mzurmand/Z35_Hardware/R&D/Research/TP4056 - OSHWLab_files/photo(1).jpg

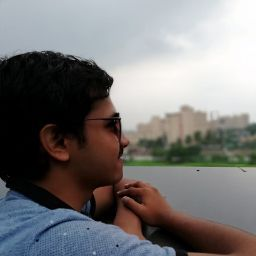
R&D/Research/TP4056 - OSHWLab_files/photo(1).jpg
