mzurmand/Z35_Hardware/R&D/Research/TP4056 - OSHWLab_files/photo.jpg

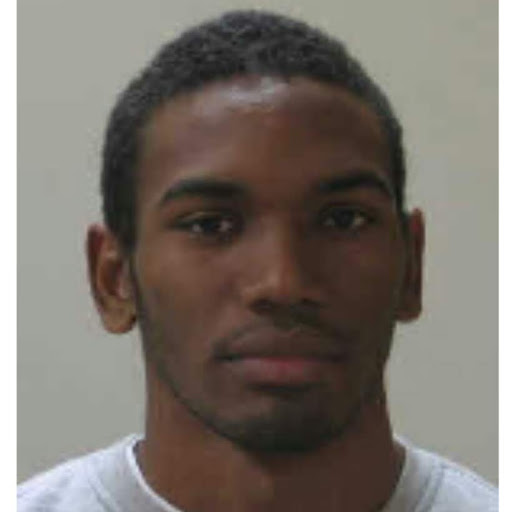
R&D/Research/TP4056 - OSHWLab_files/photo.jpg
