mzurmand/Z35_Hardware/R&D/Research/1c86db0516be416c5981fb073d690a169595acf9_2_500x334.jpeg

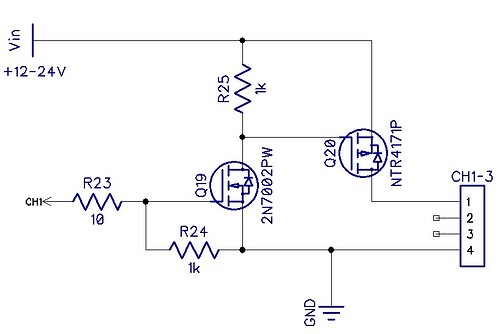
R&D/Research/1c86db0516be416c5981fb073d690a169595acf9_2_500x334.jpeg
