mzurmand/Z35_Hardware/R&D/Research/ebb98466-46d4-4202-9cf7-b3be1f33b6aa.jpg

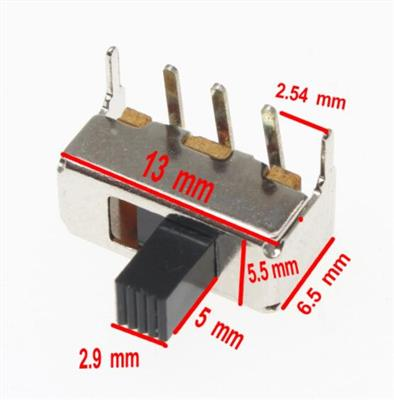
R&D/Research/ebb98466-46d4-4202-9cf7-b3be1f33b6aa.jpg
