mzurmand/Z35_Hardware/R&D/Research/N mosfet driving P mosfet - Other Hardware _ Motors, Mechanics, Power and CNC - Arduino Forum_files/a19560f0b2fe2e72ee76713fce2fe01bb80f32ff_2_690x467.jpeg

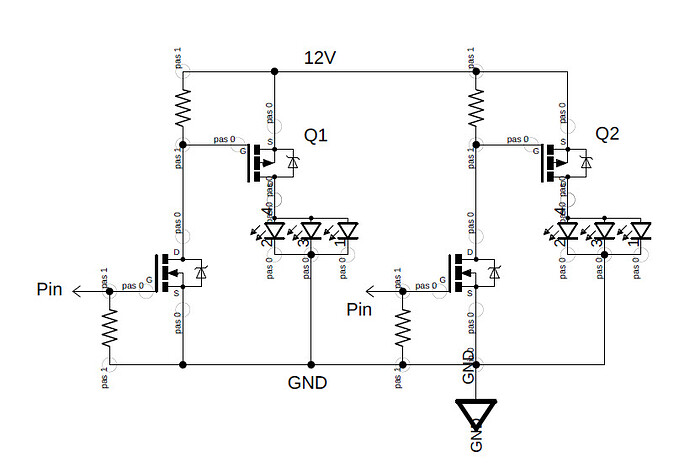
R&D/Research/N mosfet driving P mosfet - Other Hardware _ Motors, Mechanics, Power and CNC - Arduino Forum_files/a19560f0b2fe2e72ee76713fce2fe01bb80f32ff_2_690x467.jpeg
