mzurmand/Z35_Hardware/R&D/Research/TP4056 - OSHWLab_files/IDo7Sh7YOtRhSln7knlJHtKrr99G3mUUojS3hKja.jpeg

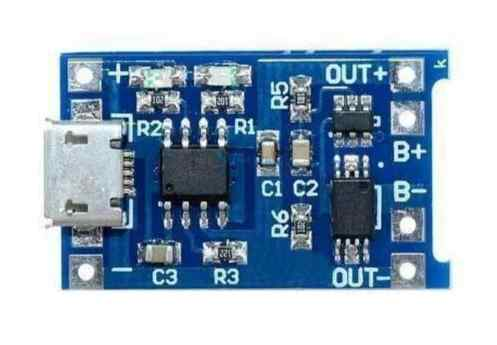
R&D/Research/TP4056 - OSHWLab_files/IDo7Sh7YOtRhSln7knlJHtKrr99G3mUUojS3hKja.jpeg
