mzurmand/Z35_Hardware/R&D/Research/TP4056 - OSHWLab_files/RLOdjxhjYpKyfk1iUPSjZLQWYawQvPg69q5MmfHB.png

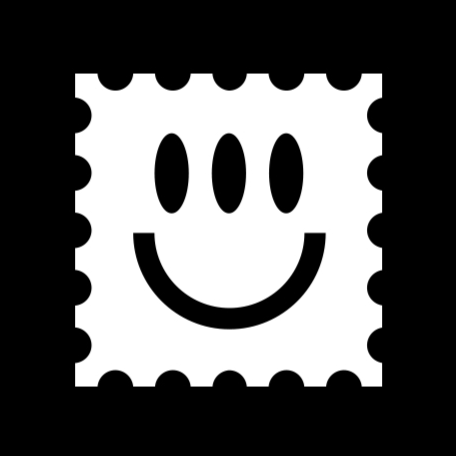
R&D/Research/TP4056 - OSHWLab_files/RLOdjxhjYpKyfk1iUPSjZLQWYawQvPg69q5MmfHB.png
