mzurmand/Z35_Hardware/R&D/Research/TP4056 - OSHWLab_files/uWVNVODcDzgOFQ3FyNXB1rH79NLc275yuhar6eYj.jpeg

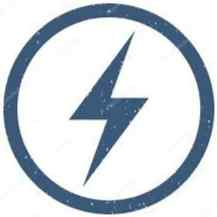
R&D/Research/TP4056 - OSHWLab_files/uWVNVODcDzgOFQ3FyNXB1rH79NLc275yuhar6eYj.jpeg
