mzurmand/Z35_Hardware/R&D/TP4056 - OSHWLab_files/no-content.81aa631d.png

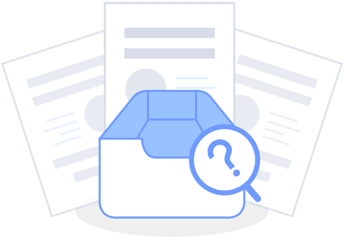
R&D/TP4056 - OSHWLab_files/no-content.81aa631d.png
