mzurmand/Z35_Hardware/R&D/TP4056 - OSHWLab_files/O2vb7wtJYsDGfwBd00tpWdqS6tXn5qfObE9fvtKy.png

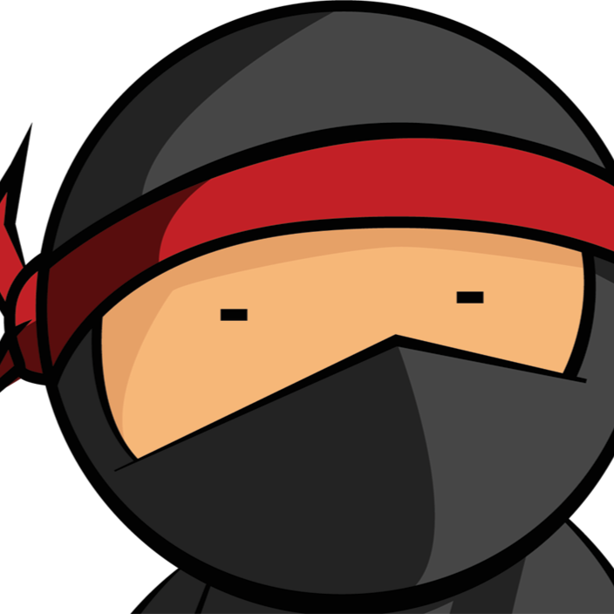
R&D/TP4056 - OSHWLab_files/O2vb7wtJYsDGfwBd00tpWdqS6tXn5qfObE9fvtKy.png
