mzurmand/Z35_Hardware/R&D/TP4056 - OSHWLab_files/PfCtYKN4fJ545DFiAe96VsUarYVP0kseUWtu5ZxB.jpeg

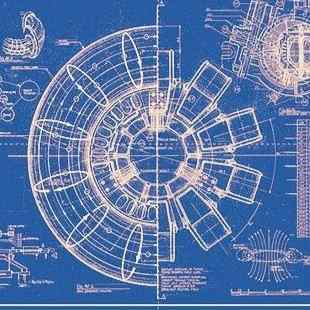
R&D/TP4056 - OSHWLab_files/PfCtYKN4fJ545DFiAe96VsUarYVP0kseUWtu5ZxB.jpeg
