mzurmand/Z35_Hardware/R&D/Wireless box/1-22.jpg.webp

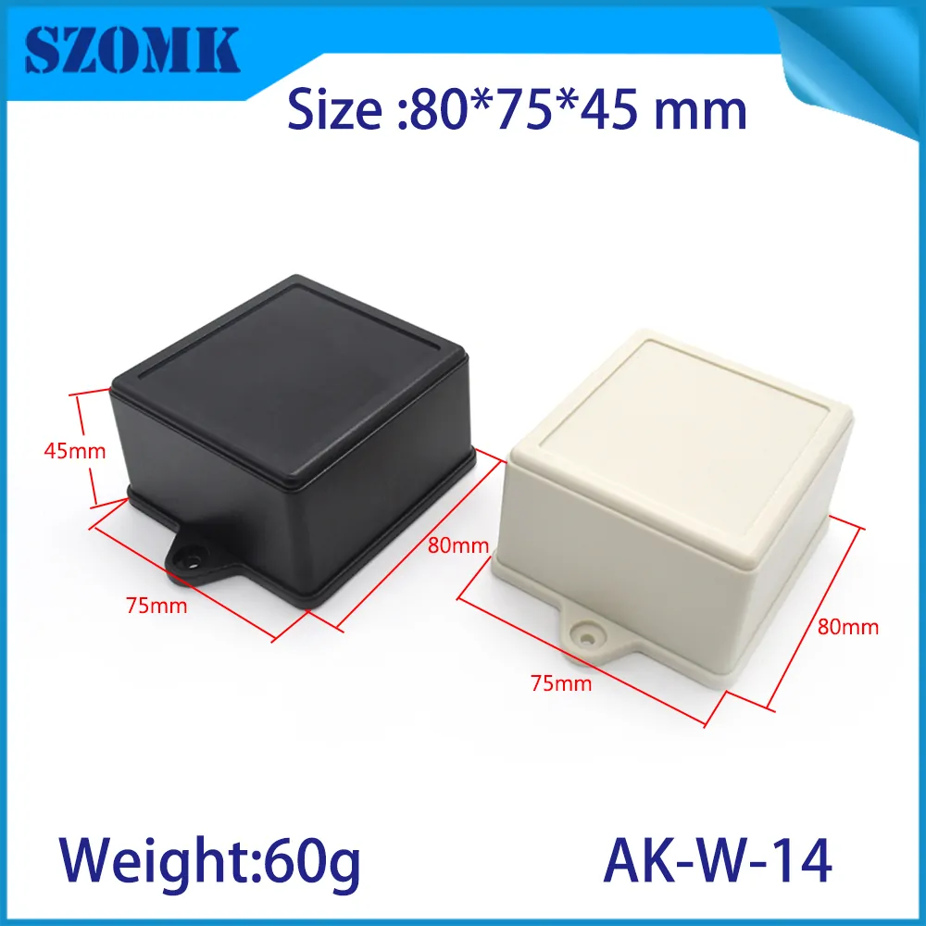
R&D/Wireless box/1-22.jpg.webp
