mzurmand/Z35_Hardware/R&D/Wireless box/4-23.jpg.webp

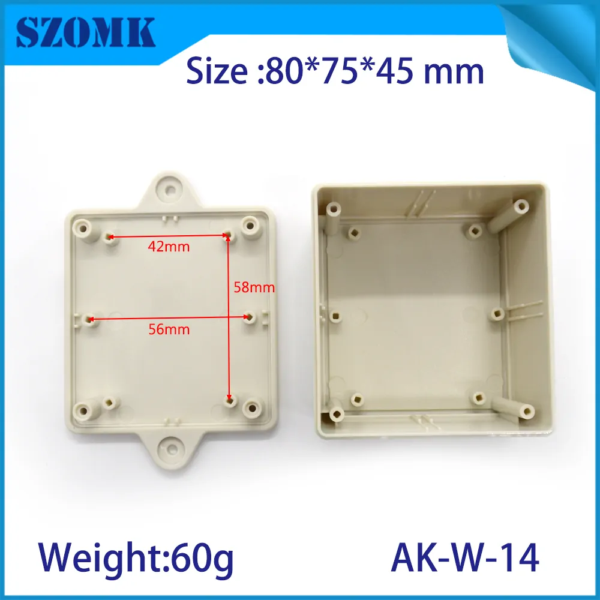
R&D/Wireless box/4-23.jpg.webp
