mzurmand/Z35_Hardware/Z35.xlsx

Line # | Name | Description | Designator | Quantity | Manufacturer 1 | Manufacturer Part Number 1 | Manufacturer Lifecycle 1 | Supplier 1 | Supplier Part Number 1 | Supplier Unit Price 1 | Supplier Subtotal 1
 | USB Connector | USB Connector-A Type | ADC1, ADC2, GSM1, SHT1 | 4
 | LCD | Alphanumic LCD | ALCD1 | 1
 | CR2032 | Battry Backup | BT1 | 1
 | 1000uF | Cap electrolitic radial | C1, C6, C61, C76 | 4
 | 10uF | Cap electrolitic radial | C2, C3, C8, C11, C62, C73, C78 | 7
 | 100uF | Cap electrolitic radial | C4 | 1
 | 220uF | Cap electrolitic radial | C5 | 1
 | 100nF/400v | Bipolar Capacitor | C7 | 1
 | 2.2uF-50v | Cap electrolitic radial | C9 | 1
 | 1000u | Cap electrolitic radial | C10 | 1
 | 10uF-50v | Cap electrolitic radial | C12 | 1
 | 100nF | CAP 0805 | C13, C22, C25, C27, C32, C33, C35, C36, C37, C40, C43, C44, C45, C46, C47, C48, C49, C60, C71, C74, C75, C77, C80 | 23
 | 100nF | 0603 C 100nF Ceramic Multilayer Capacitor, 25 V, +125degC, X7R Dielectric, +/-5% | KEMET C0603C104J3RACTU | C14, C15, C17, C23, C26, C30, C31, C38, C39, C51, C52, C55, C56, C57, C58, C59 | 16
 | 1uF | 0603 C 100nF Ceramic Multilayer Capacitor, 25 V, +125degC, X7R Dielectric, +/-5% | KEMET C0603C104J3RACTU | C16, C19 | 2
 | 15pF | 0603 C 100nF Ceramic Multilayer Capacitor, 25 V, +125degC, X7R Dielectric, +/-5% | KEMET C0603C104J3RACTU | C18, C24, C28, C29, C53, C54 | 6
 | 10nF | 0603 C 100nF Ceramic Multilayer Capacitor, 25 V, +125degC, X7R Dielectric, +/-5% | KEMET C0603C104J3RACTU | C20 | 1
 | 4.7uF | 0603 C 100nF Ceramic Multilayer Capacitor, 25 V, +125degC, X7R Dielectric, +/-5% | KEMET C0603C104J3RACTU | C21, C50 | 2
 | 15pF | CAP 0805 | C34, C42 | 2
 | 470nF | CAP 0805 | C41 | 1
 | 10uF | CAP 0805 | C63, C64, C70, C72 | 4
 | 10uF | 0603 C 100nF Ceramic Multilayer Capacitor, 25 V, +125degC, X7R Dielectric, +/-5% | KEMET C0603C104J3RACTU | C65, C66 | 2
 | 22uF | CAP 0805 | C67, C68, C69 | 3
 | BTA41 |  | CR1 | 1
 | LED 5MM | Light Emitting Diode | D1, D2, D3, D4, D5, D6, D7, D8 | 8
 | SMD 1N4007 | Diode SMD Pakage | D9, D10, D14, D15, D16, D17, D18, D19, D20, D24, D25 | 11
 | SS34 | Diode SMD Pakage | D11, D12, D13, D22, D23 | 5
 | LED3MM | Light Emitting Diode | D21 | 1
 | B1205S-2WR3 | 2W, constant voltage input, isolated ,unregulated single output, DC DC power module | DC1 | 1
 | 6.2V | DIODE ZENER GENERAL | DZ1 | 1
 | PC817 | Single Optocoupler-PC817 | IC1, IC2, IC3, IC4, IC5, IC6, IC7, IC8, IC9 | 9
 | LM2596-3v3 | SIMPLE SWITCHER® Power Converter 150kHz, 3A Step-Down Voltage Regulator | IC10 | 1
 | STM32G030C8T6 | ARMÂ® CortexÂ®-M0+ series Microcontroller IC 32-Bit Single-Core 64MHz 64KB (64K x 8) FLASH 48-LQFP (7x7) | IC11 | 1
 | Cooler Conector | 0.5mm pins | j2, j3 | 2
 | DC Power Jack | DC Power Jack. Center Pin 2.5mm. Diameter: 5.7mm | J1, J5 | 2
 | Battery | Connector 2 Male | J4 | 1
 | USB | 4 Pin + 1 Shield USB Receptacle | J6 | 1
 | Jumper | Jumper | JP1, JP2 | 2
 | Key-12*12 |  | K1, K2, K3, K4 | 4
 | Relay | SPDT Relay | K5, K6, K7, K8, K9 | 5
 | 33uH | Inductor With Magnetic core 1Dot | L1 | 1
 | 1.5uH | SMD Power Choke Coil 1.5uH 18A 7.3x6.6mm | L2 | 1
 | Green | LED Green 1C 2A | LD1 | 1
 | Red | LED Red 1C 2A | LD2 | 1
 | Screw3mm | Board Screw With Spacer 3mm | M1, M2, M3, M4, M5, M6, M7, M8, M9 | 9
 | MOC3021 | Opto-Triac | MOC1 | 1
 | IRFZ44 | N-Channel 55V 51A _Tc_ 80W _Tc_ Through Hole TO-220AB | Mos1 | 1
 | NRF24L01+ | RF Module | NRF1, NRF2 | 2
 | Prog | Header, 5-Pin | P1, P4 | 2
 | Header 5 | Header, 5-Pin | P2, P3 | 2
 | Header 3 | Header, 3-Pin | P5 | 1
 | Header 4 | Header, 4-Pin | P6 | 1
 | 10K | Variable Resistor | POT1, POT2 | 2
 | BC337 | 45 V, 500 mA NPN general-purpose transistors | Q1 | 1
 | AO3400-5.8A | N-Channel 30 V 5.8A (Ta) 1.5W (Ta) Surface Mount SOT-23 | Q1, Q6 | 2
 | IRLML6402TRPBF | P-Channel 20 V 3.7A (Ta) 1.3W (Ta) Surface Mount Micro3Ã¢â€žÂ¢ /SOT-23 | Q2, Q4, Q5 | 3
 | FS8205A | Dual N-Channel Enhancement Mode Power MOSFET | Q7 | 1
 | Array Resistor-4K7 | Resistor Pack | R1 | 1
 | 360R | RES Axial 0.25W | R2, R3 | 2
 | 100R | RES Axial 0.25W | R4 | 1
 | 10K | Resistor - 0.1% | R5, R9, R10, R11, R12, R45 | 6
 | 1K2 | Resistor - 0.1% | R6, R47 | 2
 | 10K | RES 0805 | R7, R8, R29, R37, R40, R42, R46, R51, R56, R57, R60, R65, R69, R75 | 14
 | 270R | RES 0805 | R13, R14, R15, R16, R17, R18, R19, R22, R23, R27, R33, R38 | 12
 | 220R | RES 0805 | R20, R34 | 2
 | 1K | RES 0805 | R21, R53, R71, R72, R73 | 5
 | 1K | RES 1206 | R24, R26, R28, R30, R32, R35, R36, R39 | 8
 | 20K | RES 0805 | R25 | 1
 | 100R | RES 0805 | R31, R44, R52, R64, R70 | 5
 | 100K | RES 1206 | R41, R43 | 2
 | 1K | Resistor - 0.1% | R48, R49, R58, R59 | 4
 | 02LDR1 | 12mm LDR / PIN to PIN is 9mm | R50 | 1
 | 4K7 | RES 0805 | R54, R55, R74 | 3
 | 470K | RES 0805 | R61 | 1
 | 100K | RES 0805 | R62 | 1
 | 150K | RES 0805 | R63 | 1
 | 12K | RES 0805 | R66 | 1
 | 33K | RES 0805 | R67 | 1
 | 470R | RES 0805 | R68 | 1
 | 1K5 | RES 0805 | R76 | 1
 | REL_FINDER_40.61 | 16A SPDT PCB Relay, 40.61 Serie | RL1, RL2 | 2
 | switch |  | S1 | 1
 | KK® | Connector 2 Male | Sp1 | 1
 | SS-12F23 | SPDT Switch | SW1 | 1
 | DG35-5pin | DG35C_Contacts pitch 8.25 mm | T1, T2, T3, T4, T5 | 5
 | 6N137 | HIGH SPEED-10 MBit/s LOGIC GATE OPTOCOUPLERS | U1, U2 | 2
 | STM32G431RBT6 | ARMÂ® CortexÂ®-M4F STM32G4 Microcontroller IC 32-Bit Single-Core 170MHz 128KB (128K x 8) FLASH 64-LQFP (10x10) | U3 | 1
 | CA-IS3722HS | CA-IS3722 High-Speed Dual-Channel Digital Isolators | U4, U6 | 2
 | W25Q64BVSSIG | FLASH - NOR Memory IC 64Mb (8M x 8) SPI 80 MHz 8-SOIC | U5 | 1
 | PAM8403 | Audio Amp Speaker 2-CH Stereo 3.2W Class-D 16-Pin SOP T/R | U7 | 1
 | ULN2003A | SEVEN DARLINGTON ARRAYS | U8 | 1 |  |  |  | Digi-Key | ULN2003A
 | ESP32-WROOM-32D-N4 | Bluetooth, WiFi 802.11b/g/n, Bluetooth v4.2 +EDR, Class 1, 2 and 3 Transceiver Module 2.4GHz ~ 2.5GHz Integrated, Trace Surface Mount | U9 | 1
 | TPS63070RNMT | TPS63070 2-V to 16-V Buck-Boost Converter With 3.6-A Switch Current | U10 | 1
 | DW01A | One Cell Lithium-ion/Polymer Battery Protection IC | U11 | 1
 | TP4056 | Complete single cell Li-Ion battery with a constant current / constant voltage linear charger | U12 | 1
 | SHT40 | Digital Relative Humidity Temperature Sensor, Â±1.8 / max 3.5 %RH, Â±0.2 Â°C, Ultra-Low-Power | U13 | 1
 | 5v | x.x Volt, 800mA Low-Dropout Linear Regulator, 4-pin SOT-223 | UP1, UP4 | 2
 | 3.3v | x.x Volt, 800mA Low-Dropout Linear Regulator, 4-pin SOT-223 | UP2 | 1
 | 5v - 3.3v | x.x Volt, 800mA Low-Dropout Linear Regulator, 4-pin SOT-223 | UP3 | 1
 | 8MHz | XTAL Crystal | Y1, Y3 | 2
 | 32.768KHZ | 32.768 kHz Â±20ppm Crystal 12.5pF 70 kOhms 2-SMD, No Lead | Y2 | 1
