mzurmand/Z35_Hardware/R&D/Wireless box/d142.pdf

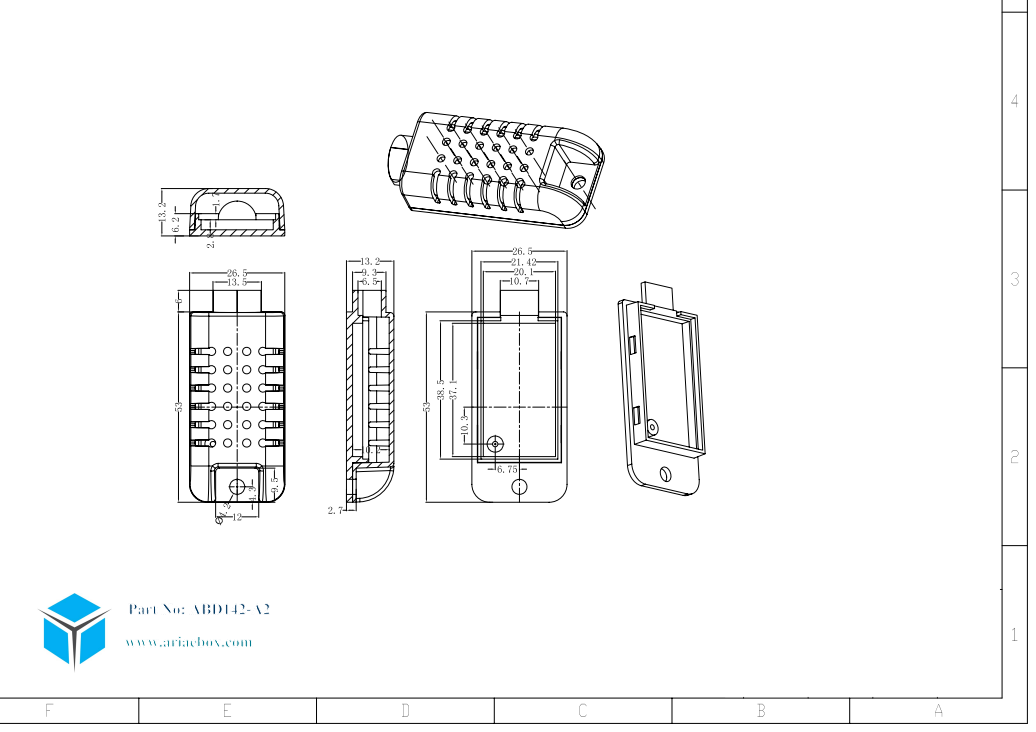
[picture p15: page 1]
Part No: ABD142-A2

www.ariaebox.com
