mzurmand/Z35_Hardware/(list of files, drawings)

Other design files:
PCB_Z35.PcbDoc
PCB_Z35_Sensors.PcbDoc
PCB_Z35_Wireless_board.PcbDoc
Sch_Z35.SchDoc
Sch_Z35_Sensors.SchDoc
Sch_Z35_Wireless_board.SchDoc
Z35.PrjPcb
