mzurmand/Z35_Hardware/(notices)

Notices in the files:
README.md:
License: Apache 2.0
